NormalAlkene/auto_presser/3dp/auto_click-Main-6.3mf

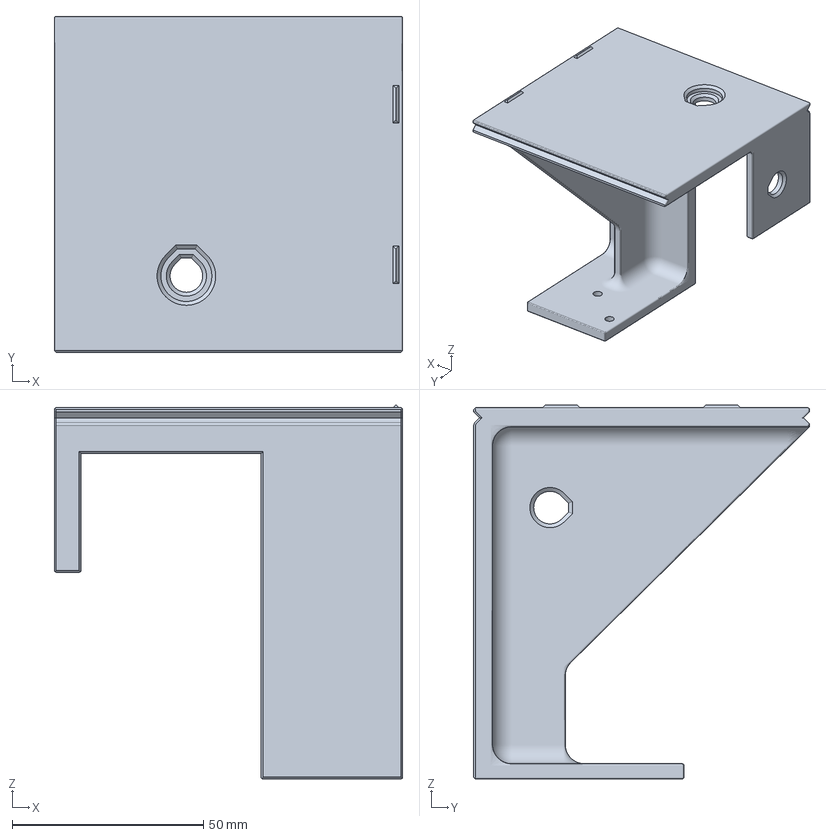
[picture p2: CAD file, 2026-10-18]
3dp/auto_click-Main-6.3mf
91.0 x 87.8 x 97.7 mm
