NormalAlkene/auto_presser/3dp/auto_click-PCBShell-6.3mf

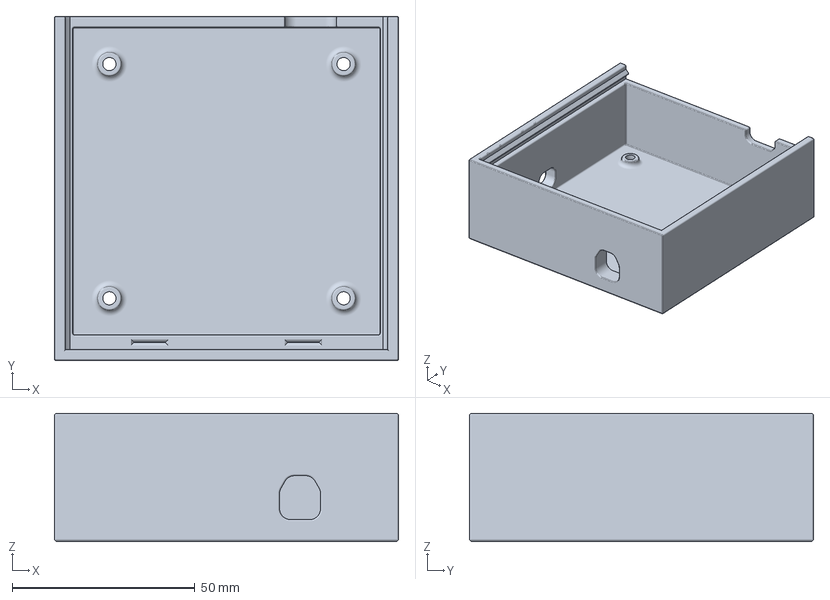
[picture p3: CAD file, 2026-10-18]
3dp/auto_click-PCBShell-6.3mf
94.0 x 94.0 x 35.0 mm
