NormalAlkene/auto_presser/3dp/auto_click.FCStd

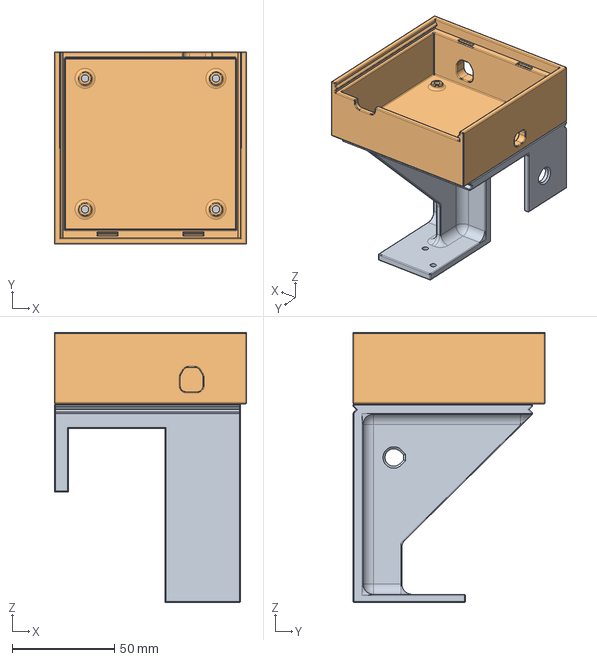
[picture p4: CAD file, 2026-10-18]
3dp/auto_click.FCStd
94.0 x 94.0 x 132.0 mm
Main
PCBShell
